yiwenyaoandrew/STM32-line-buggy/project_picture.jpg

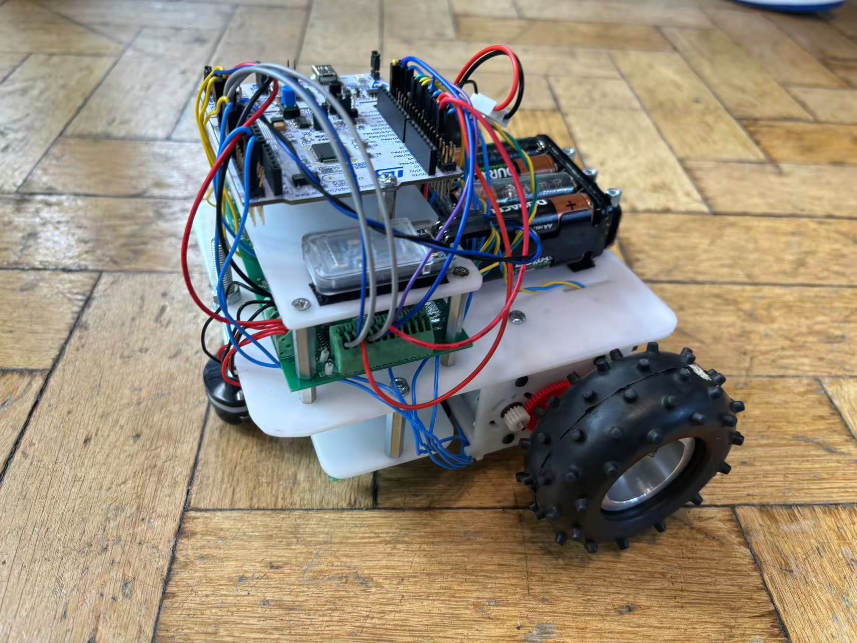
project_picture.jpg
