yiwenyaoandrew/STM32-line-buggy/my Chassis new.SLDPRT

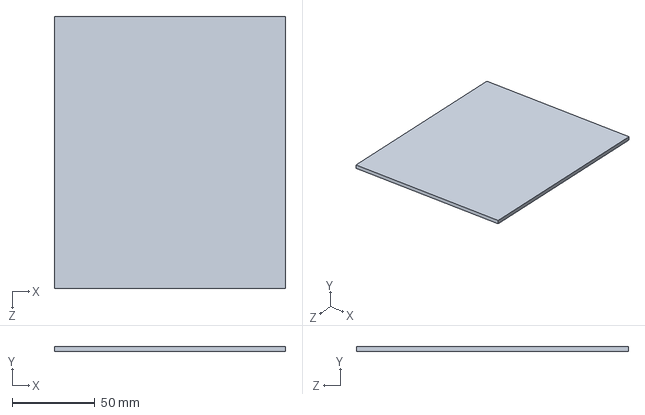
[picture p32: CAD file, 2026-07-06]
my Chassis new.SLDPRT
140.0 x 3.00 x 165.0 mm
