yiwenyaoandrew/STM32-line-buggy/2nd layer chassis.SLDPRT

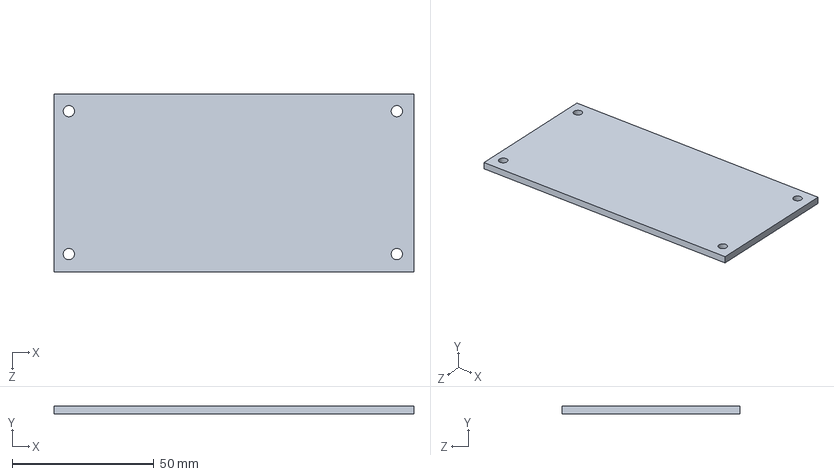
[picture p33: CAD file, 2026-07-06]
2nd layer chassis.SLDPRT
127.2 x 3.00 x 62.7 mm
