yiwenyaoandrew/STM32-line-buggy/(list of files, cad)

Other CAD files:
my Chassis.SLDPRT
